brandon9838/Verilog-Implementation-of-Decision-Tree-Accelerator/DecisionTreeAccelerator.pdf

# Verilog Implementation of Decision Tree Accelerator

Bo-Fan, Chen
Side Project for 2022 Job Interviews

## Outline

- Problem/ Dataset
- Software
- Conversion
- Hardware

## Problem Description

- Predict payment failure
- Decision tree
- Decision tree can be used in various fields
- Some of them require high processing speed
- One solution is to adopt a hardware accelerator dedicated for decision tree

## Dataset

- Label
- Payment success/fail, 0/1
- Features
- 13 features for each application data
- Including FICO score, interest rate…
- 9578 loaning data
- 8045 successes / 1533 fails

## Data Pre-process

- “Loaning Purpose” is a categorical feature
- 6 categories
- One hot encoding
- 18 total features
- Normalize the features to 0~255, integer
- Decision thresholds will also be 0~255, integer!
- Hardware-friendly modification
- At the cost of potential performance drop
- Training/Testing split
- Randomly sample
- 6704/2874

## Outline

- Problem/ Dataset
- Software
- Conversion
- Hardware

## Decision Tree

- Use the decision tree provided by scikit-learn
- This work focused on the hardware implementation
- Fine-tuning and software analyses (exp: max-leaf-num, AUROC) are neglected
- Confusion matrix on the test set (Before/ After converting to integers)
Ans\Pred | T | F
T | 1967 | 464
F | 283 | 160
Ans\Pred | T | F
T | 1970 | 461
F | 284 | 159

## Result Tree Structure

- Max Node Index: 30
- Max-depth: 6

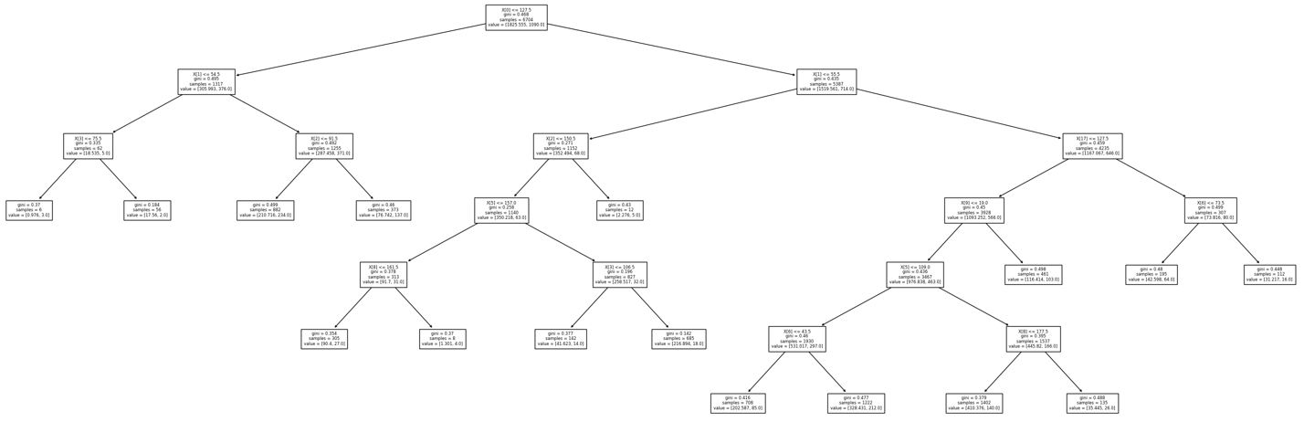
[picture p1: figure]

## Outline

- Problem/ Dataset
- Software
- Conversion
- Hardware

## Observation

- Naïve thought
- Core function is to “move down 1 layer”
- To move down 1 layer, we need 3 parameters:
- The index of feature
- The threshold
- The index of the children

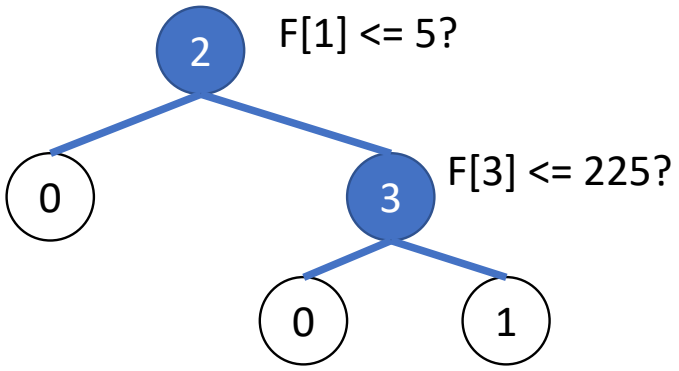
[picture p2: figure]

## Conversion Strategy

- Convert python code to Verilog hardware design
- Parse all the parameters into 3 memories
- Leaf nodes share the same slot

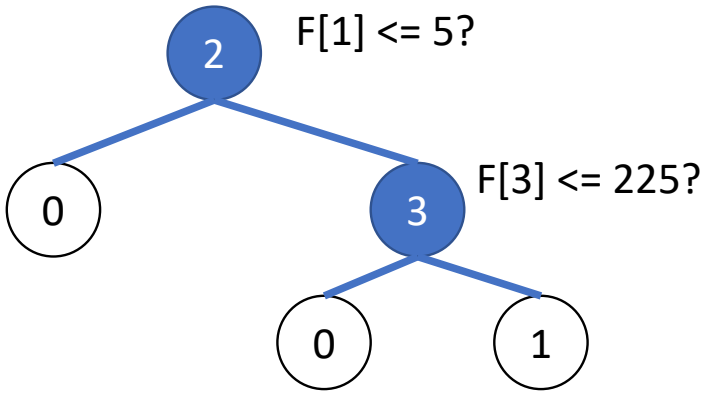
[picture p3: figure]

Feature Index | Threshold | Child
0 | 0 | 0
0 | 0 | 0
| | 0
1 | 5
3 | 225 | 0
0 | 0 | 0
0 | 0 | 3
0 | 0 | 0
0 | 0 | 1

Node 0

Node 2
(root
node)

## Feature/Node Pruning

- The decision tree generated from scikit-learn can be further optimized
- Not all 18 features are used
- Prune the unused ones. Re-index the features left.
- Not all 31 node indexes are occupied
- Leaf nodes do not need a unique index!
- Prune the unused ones. Re-index the nodes.

## Redundant Splits Pruning

- Reason: Decision tree training target
- Minimizing the weighted entropy sum after split
- Does not guarantee the split produces different predictions!
- Redundant splits are sometimes generated
- Recursively prune the redundant splits

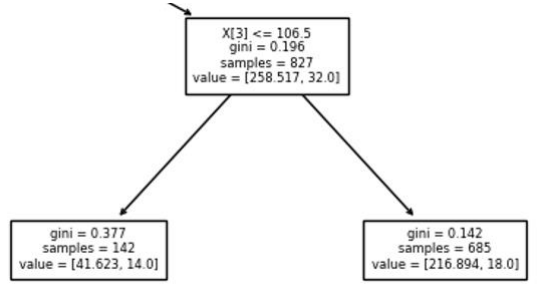
[picture p4: figure]

0.377*142+0.142*685<0.196*827

But both leaf nodes predict class 0!

## Final Tree Structure

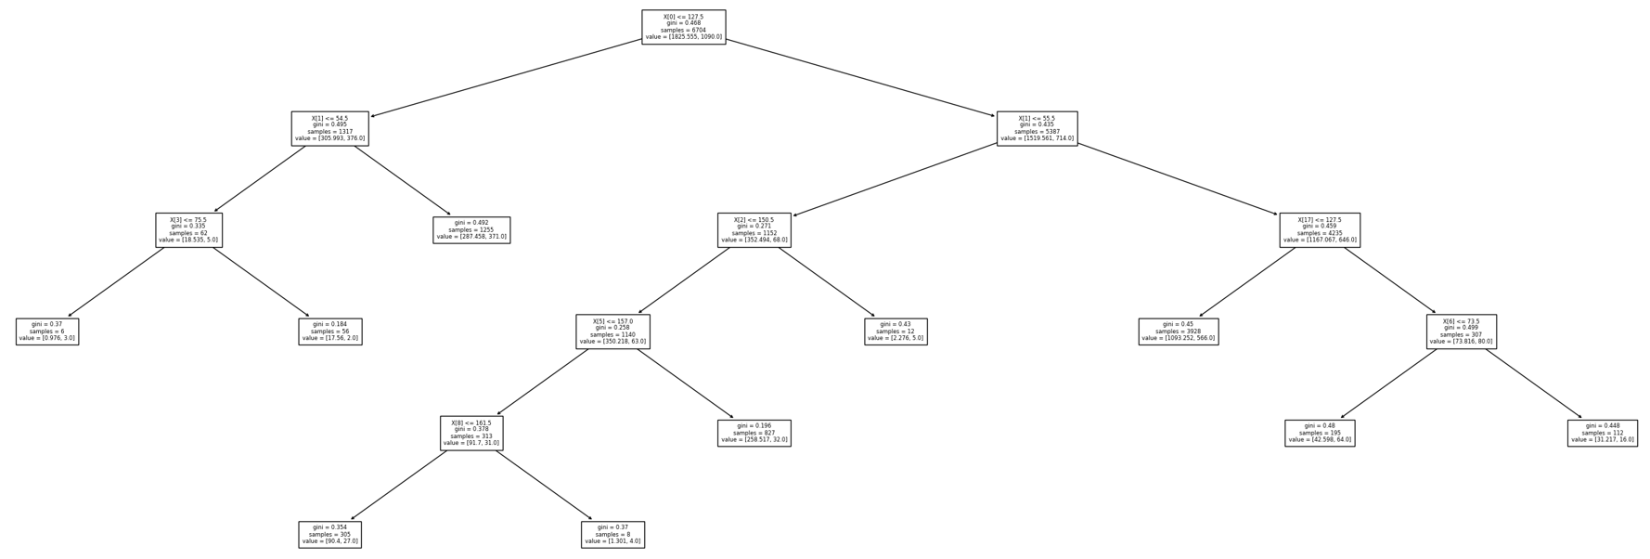
[picture p5: page 14]

- Max node index: 10
- Max-depth: 5 layers

## Outline

- Problem/ Dataset
- Software
- Conversion
- Hardware

## Top-Level View / Project Scope

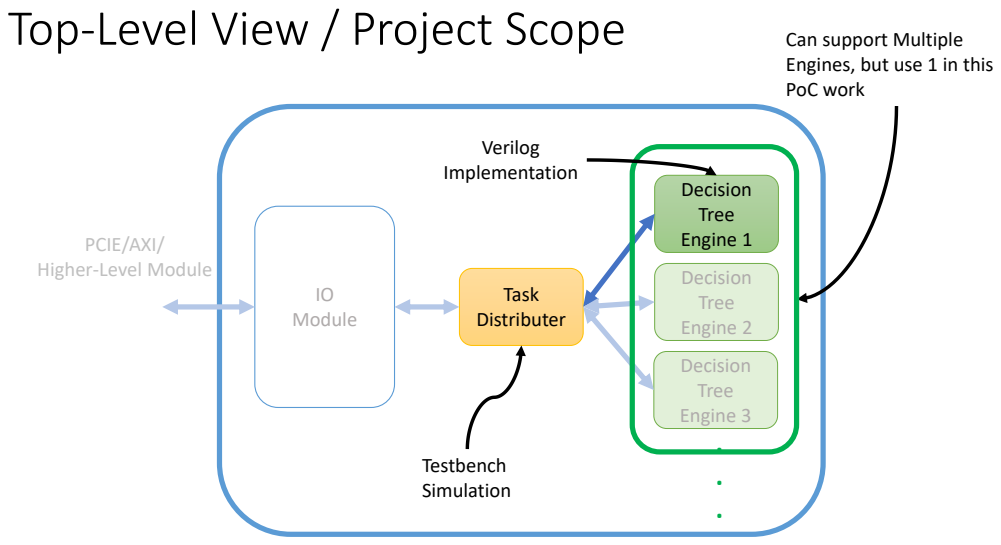
[picture p6: page 16]
IO Module; Task Distributer; Decision Tree Engine 1; Decision Tree Engine 2; Decision Tree Engine 3 . . .; Testbench Simulation; Verilog Implementation

Can support Multiple
Engines, but use 1 in this
PoC work

PCIE/AXI/
Higher-Level Module

## Architecture – Core Function

- 3-stage pipeline to move 1 layer down in the tree
- 1

st:
- Retrieve the feature index by the node index
- 2

nd:
- Select the feature using feature index
- Retrieve the threshold used
- 3

rd:
- Comparing the selected feature with the threshold
- Retrieve index of the next node

## Architecture – Core Function

- Parameter storage option
- SRAM: Better generalizability for larger trees!
- Flip-Flop array

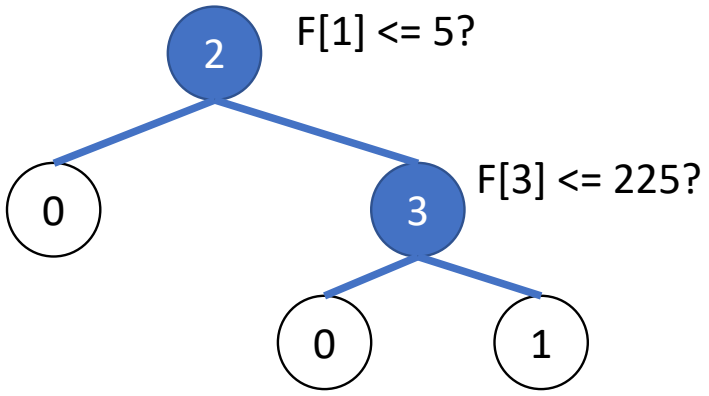
[picture p7: figure]

Feature Index | Threshold | Child
0 | 0 | 0
0 | 0 | 0
| | 0
1 | 5
3 | 225 | 0
0 | 0 | 0
0 | 0 | 3
0 | 0 | 0
0 | 0 | 1

Node 0

Node 2
(root
node)

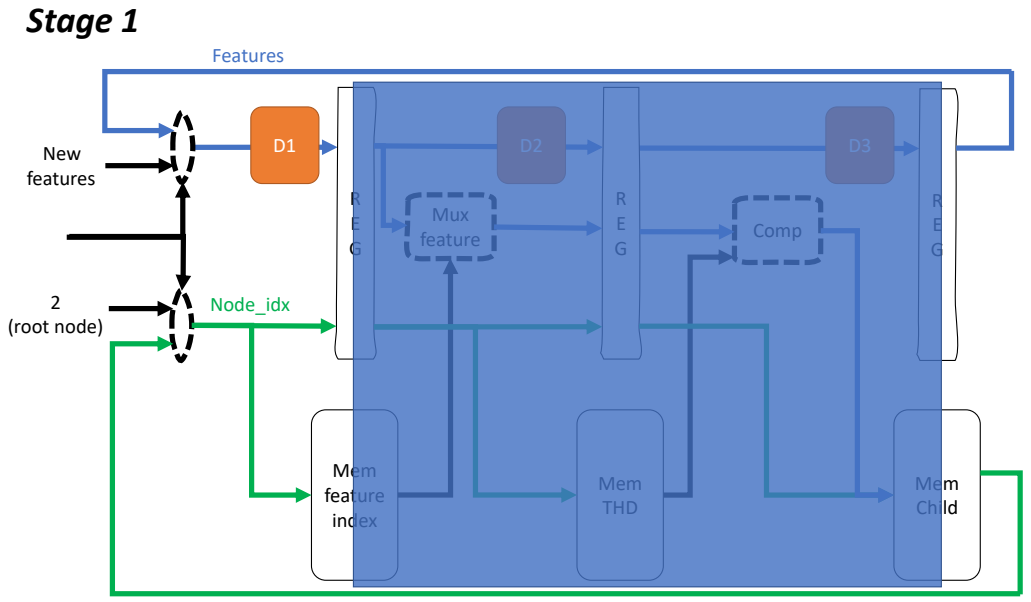
[picture p8: page 19]
Mem feature index; New features; 2 (root node); Mem Child; Mem THD; Mux; feature; Comp; Node_idx; Features; Stage 1

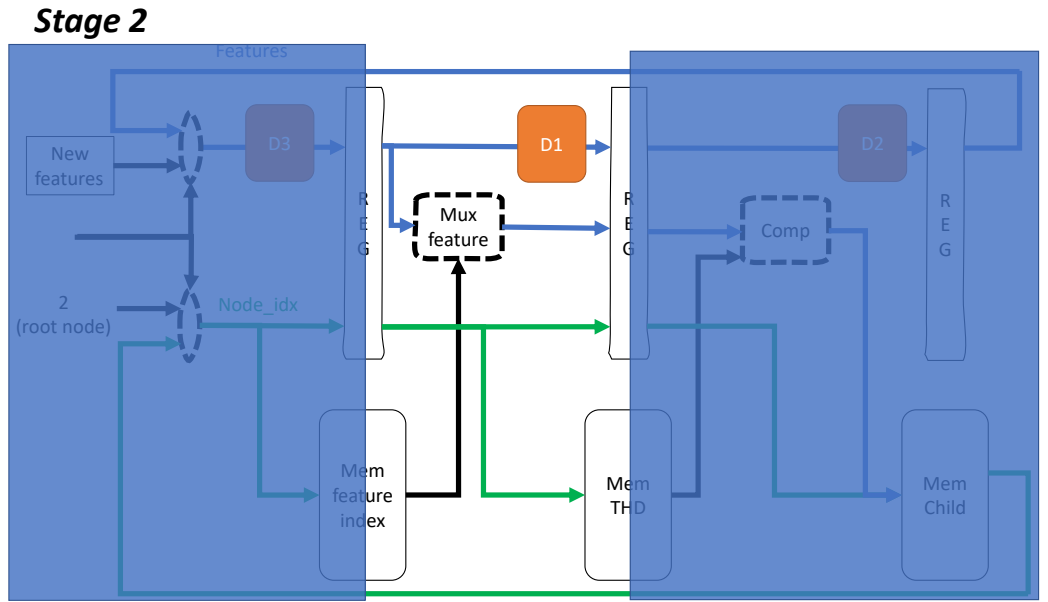
[picture p9: page 20]
Mem feature index; New features; 2 (root node); Mem Child; Mem THD; Mux; feature; Comp; Node_idx; Features; Stage 2

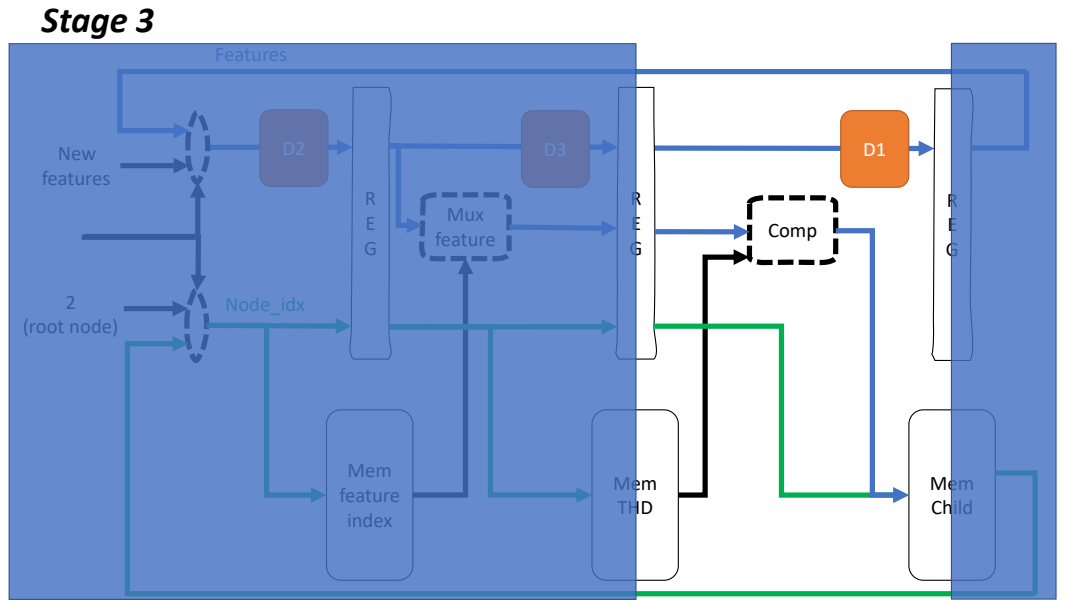
[picture p10: page 21]
Mem feature index; New features; 2 (root node); Mem Child; Mem THD; Mux; feature; Comp; Node_idx; Features; Stage 3

## Architecture – A deeper look

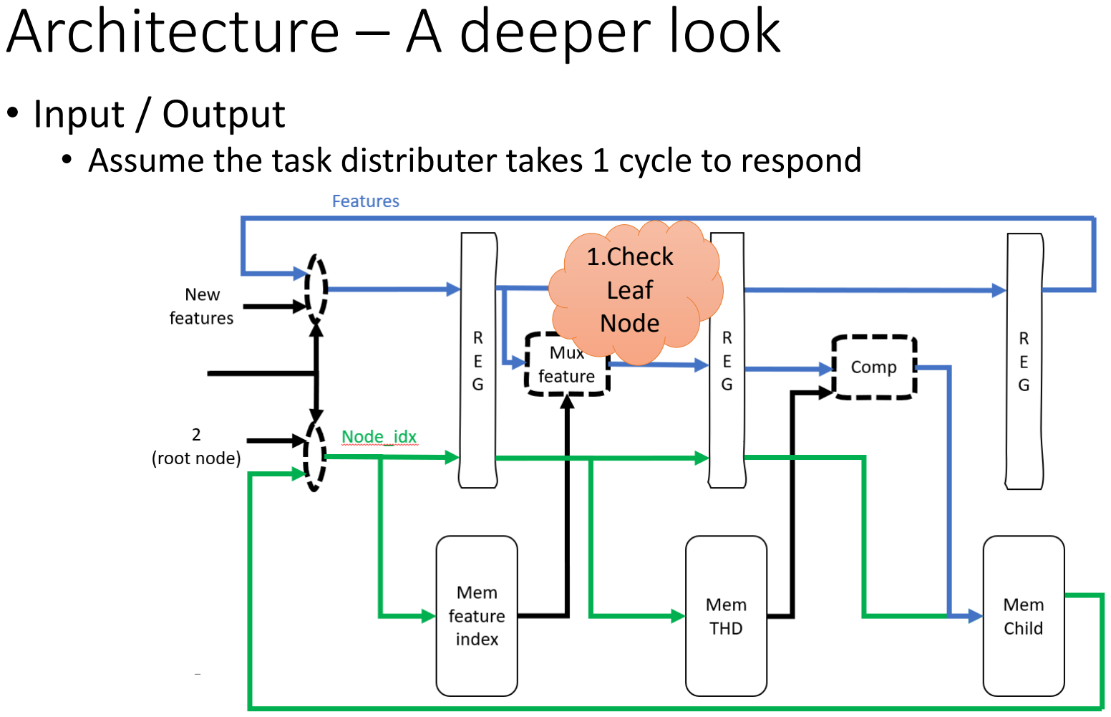
[picture p11: page 22]

- Input / Output
- Assume the task distributer takes 1 cycle to respond

1.Check
Leaf
Node

## Architecture – A deeper look

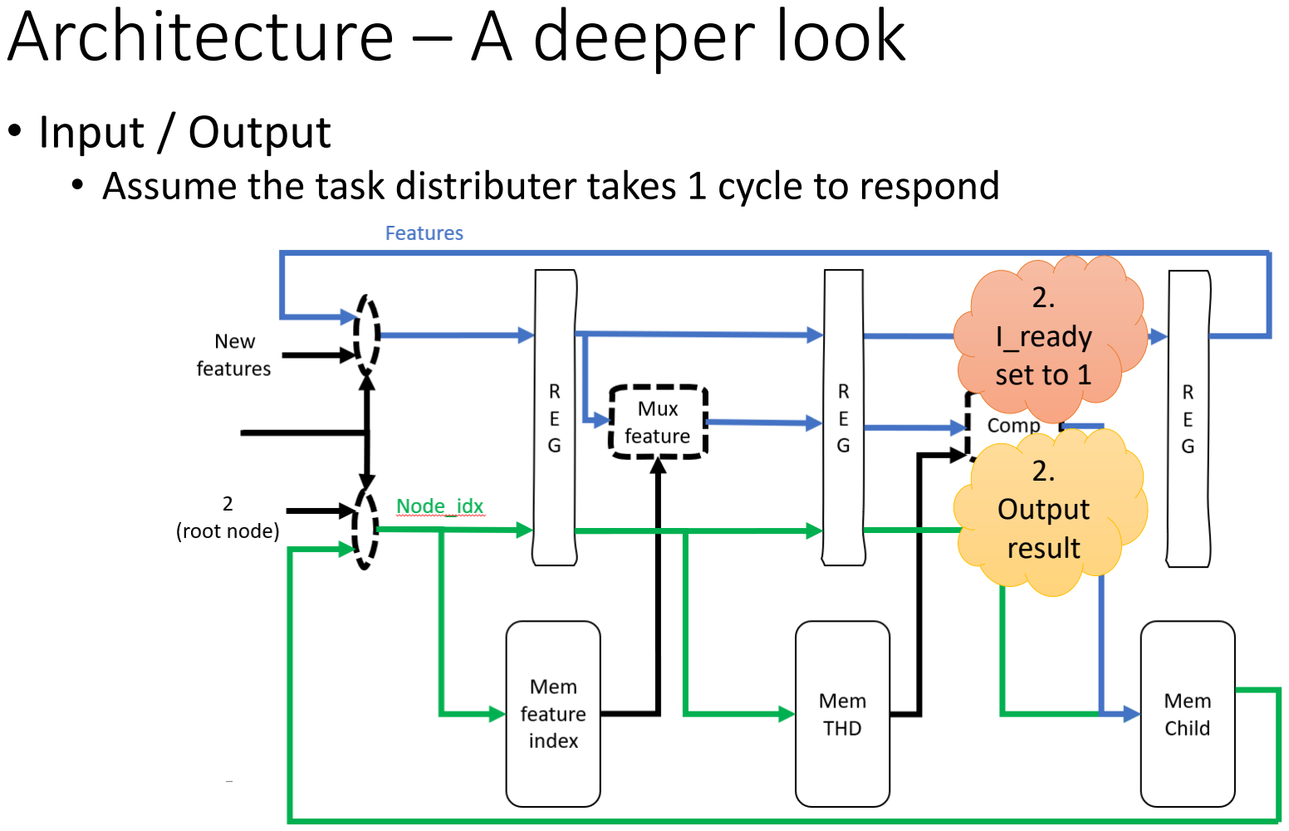
[picture p12: page 23]

- Input / Output
- Assume the task distributer takes 1 cycle to respond

2.
I_ready
set to 1

2.
Output
result

## Architecture – A deeper look

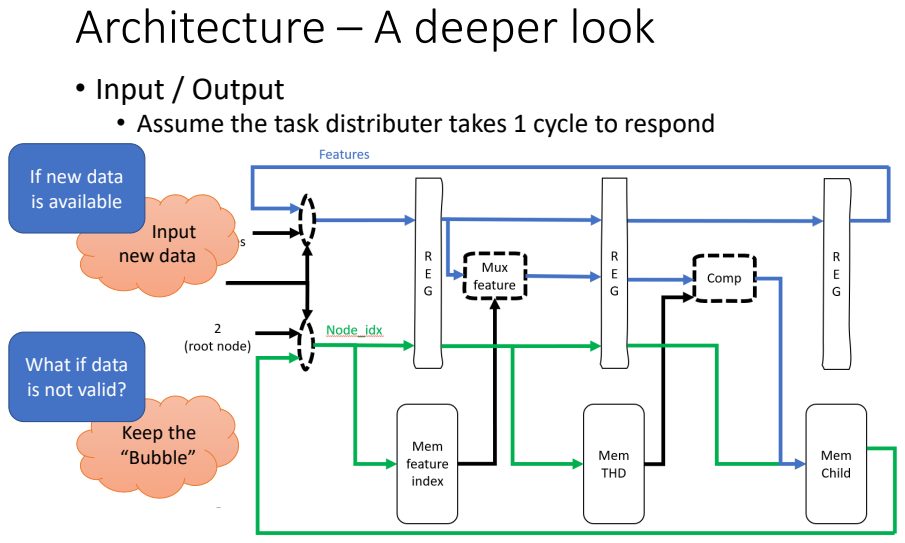
[picture p13: page 24]
Keep the “Bubble”; Input new data

• Input / Output
• Assume the task distributer takes 1 cycle to respond

If new data
is available

What if data
is not valid?

## index REG

# features 2

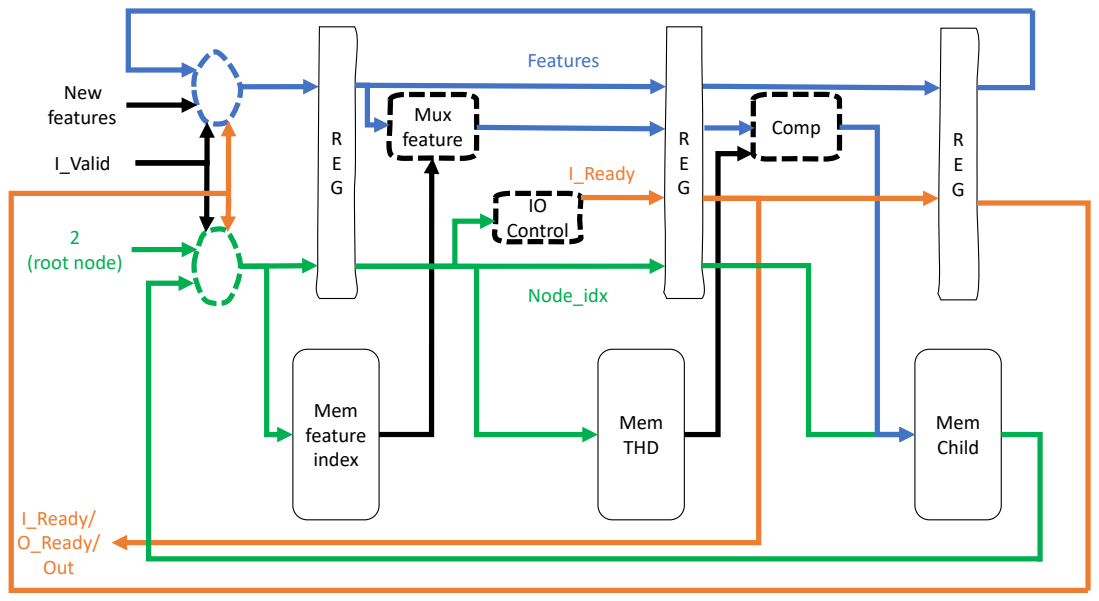
[picture p14: page 25]
Mem feature; New; (root node); Mem Child; Mem THD; REG; Mux; feature; Comp; Node_idx; Features; IO Control; I_Ready; / O_Ready; Out; I_Valid

## Architecture – A deeper look

- Memory Initialization
- Pass the params and addresses one by one
- Re-using existing input ports
- How to identify the correct instruction?
- Add a new input port, I_Mode
- 00: Initialize feature index memory
- 01: Initialize threshold memory
- 10: Initialize child node memory
- 11: Computation
- Allows parameter modification at run time!

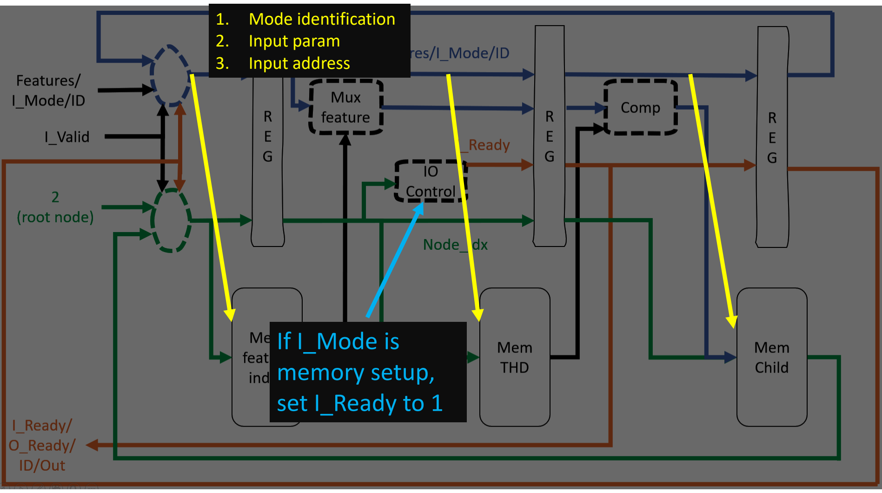
[picture p15: page 27]

1. Mode identification
2. Input param
3. Input address

If I_Mode is
memory setup,
set I_Ready to 1

## Architecture – Final thoughts

- Processing latency varies between data
- IO does not follow first-in-first-out
- Naïve solution:
- Track the data ID in each stage

## index REG

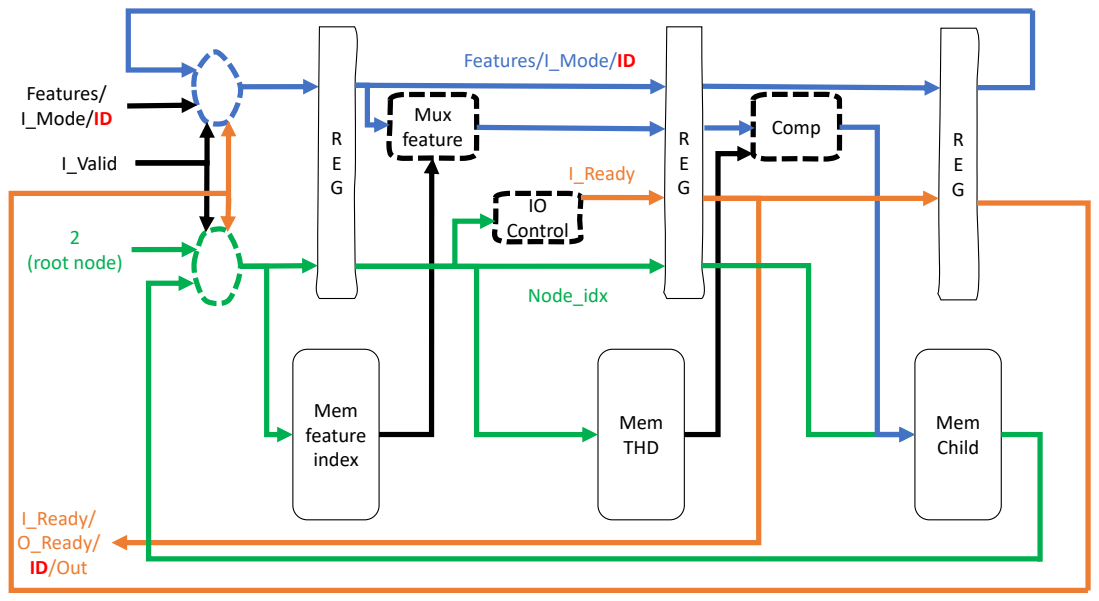
[picture p16: page 29]
Mem feature; Features/ I_Mode; 2 (root node); Mem Child; Mem THD; REG; Mux; feature; Comp; Node_idx; Features/I_Mode; IO Control; I_Ready; / O_Ready; ID/Out; I_Valid

## Synthesis

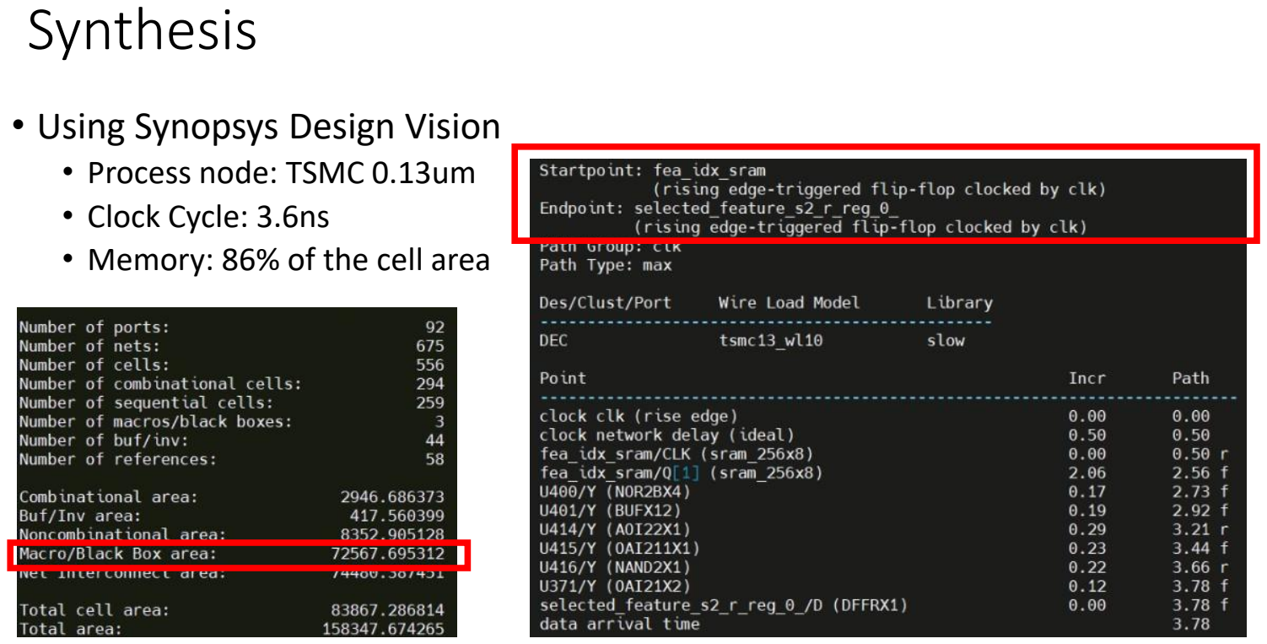
[picture p17: page 30]

- Using Synopsys Design Vision
- Process node: TSMC 0.13um
- Clock Cycle: 3.6ns
- Memory: 86% of the cell area

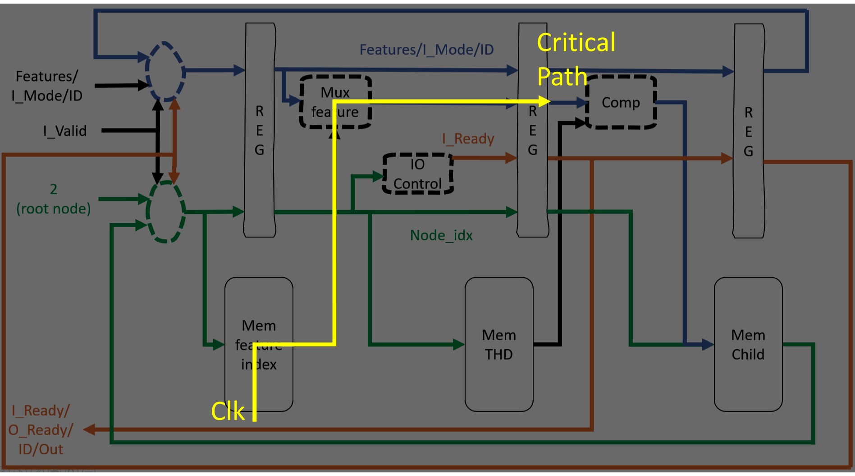
[picture p18: page 31]

Clk

Critical
Path

## Place and Route

- Using Cadence Innovus
- Utilization Rate: 0.65
- Memory dominating layout
- Floorplan, memory placement, power plan are critical to avoid violations!
- Pass P&R testbench simulation at clock cycle 3.6 ns

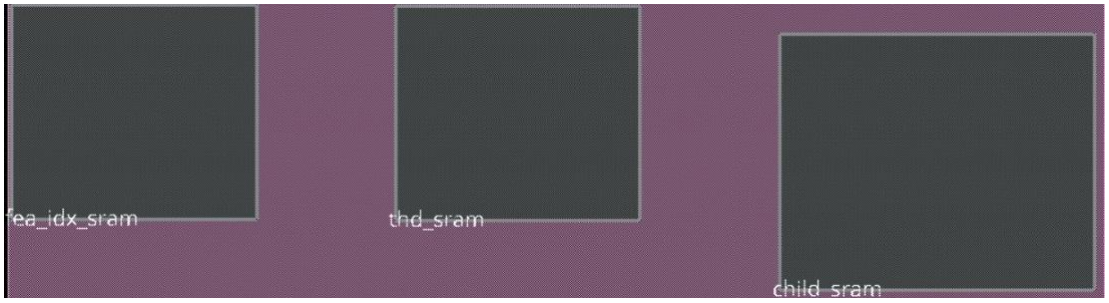
[picture p19: figure]

## Place and Route

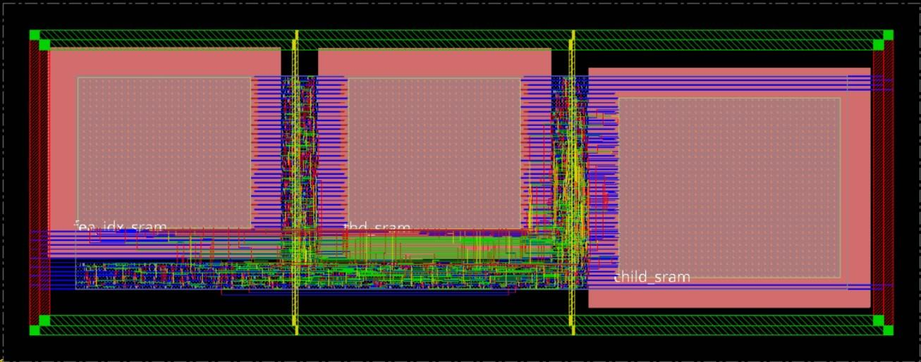
[picture p20: figure]

## Accelerator Performance

- The evaluation metric is the inference time of all 2874 testing data.
- The baseline inference time of scikit-learn decision tree, using CPU, is 1.58 ms
- Intel(R) Core(TM) i7-7700 CPU @ 3.60GHz
- The presented decision tree accelerator only requires 42.5 us!
- Including memory setup
- ~37 times faster!

## References

1. https://github.com/Shayan-Asgari/ClassificationTrees
2. https://stackoverflow.com/questions/51397109/prune-unnecessary-leaves-in-sklearn-decisiontreeclassifier (https://stackoverflow.com/questions/51397109/prune-unnecessary-leaves-in-sklearn-decisiontreeclassifier)
3. https://stackoverflow.com/questions/56334210/how-to-extract-sklearn-decision-tree-rules-to-pandas-boolean-conditions (https://stackoverflow.com/questions/56334210/how-to-extract-sklearn-decision-tree-rules-to-pandas-boolean-conditions)
4. Course material of COMPUTER-AIDED VLSI SYSTEM DESIGN, National Taiwan University

## About me

- Bo-Fan, Chen
- Nationality: Taiwan
- Language
- Mandarin
- English
- Education
- National Taiwan University
- Electric Engineering, graduated in 2019.07

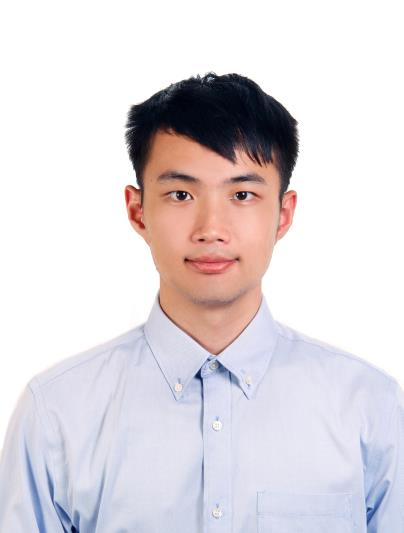
[picture p21: figure]

- Graduate Institute of Electronics Engineering, Integrated Circuits & Systems Group, Laboratory for Data Processing Systems, expect to graduate in 2022.09
- Aarhus University, Denmark
- Exchange student, from 2021.09 to 2022.07
- Software Engineering, Electric Engineering
- Academic Work
- CF-NET: Complementary Fusion Network for Rotation Invariant Point Cloud Completion, ICASSP 2022
- Skills
- Digital Circuit Design, Verilog, Synopsys Design Vision, Cadence Innovus
- Machine Learning, Python, Numpy, Pytorch, Tensorflow
- Objective
- Looking for a position as digital circuit RTL engineer. Preferred locations are: United States, Europe, Taipei.

## Contact

- Email
- sddslover@gmail.com
- LinkedIn
- linkedin.com/in/bo-fan-chen (https://www.linkedin.com/in/bo-fan-chen-a4359421b)
